CoachChuckFF/SoC-It_Hardware/sch.pdf

# USB

# POWER

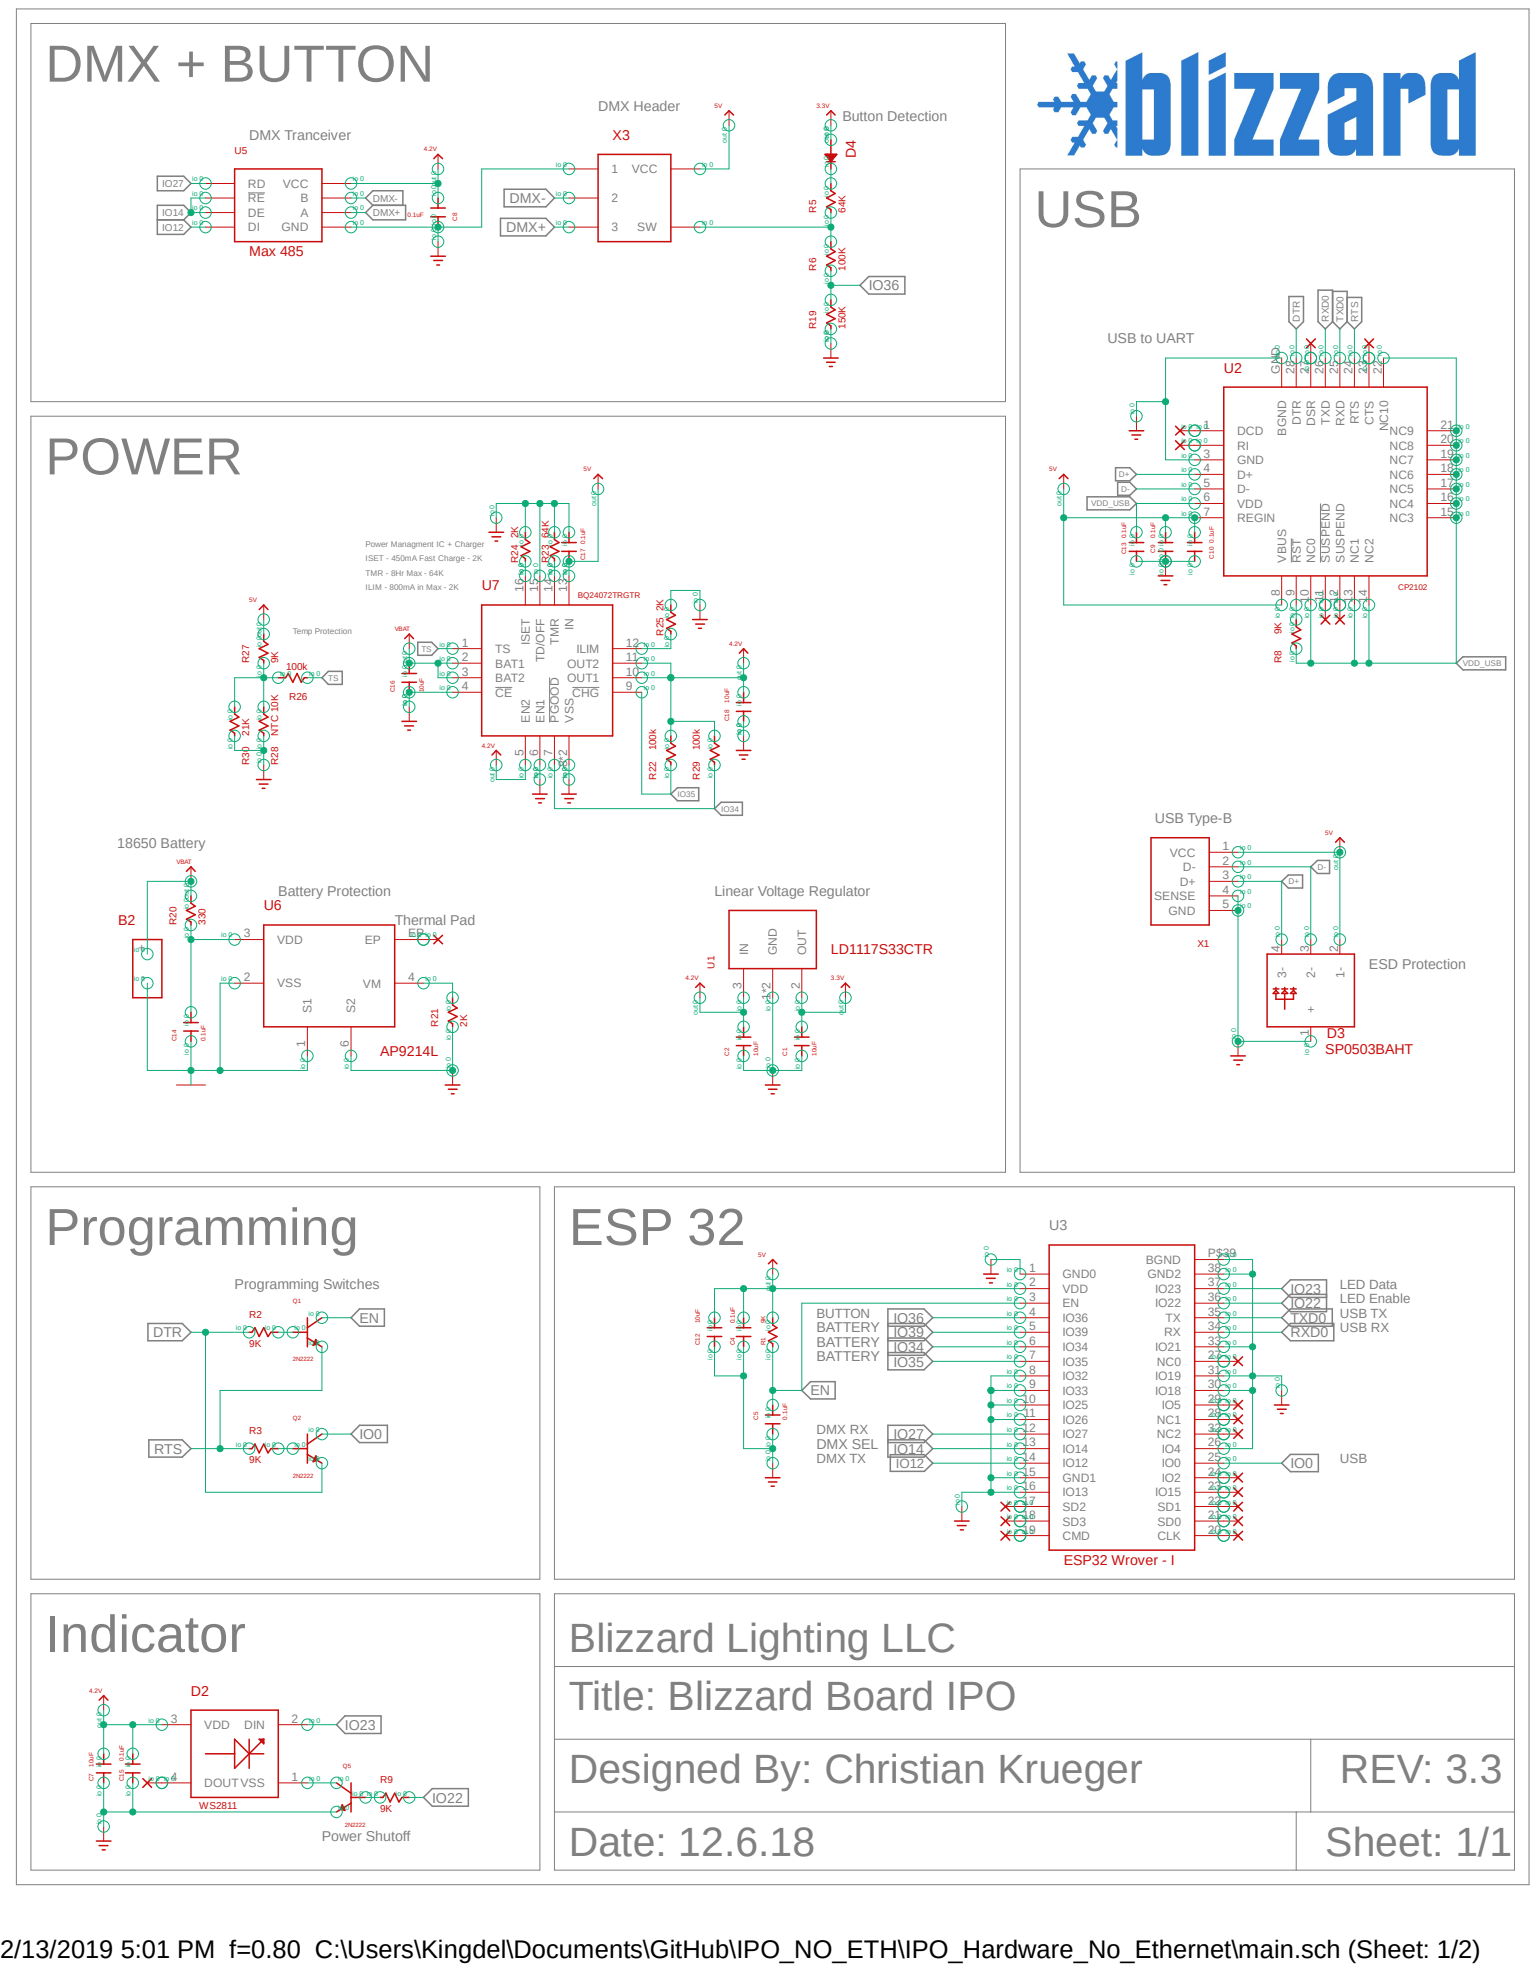
[picture p1: page 1]

9 NC0 10 SUSPEND 11 SUSPEND 12 NC1 13 NC2 14 NC3 15 NC4 16 NC5 17 NC6 18 NC7 19 NC8 20 NC9 NC10 21 22 CTS 23 RTS 24 RXD 25 TXD 26 DSR 27 DTR 28 BGND GND

Power Managment IC + Charger Temp Protection

7 VSS 8*2 CHG 9 OUT1 10 OUT2 11 ILIM 12 IN 13 TMR 14 TD/OFF 15 ISET 16

Thermal Pad Battery Protection

GND0 1 VDD 2 EN 3 | io 0

io 0 | IO26 11 | io 0
io 0 io 0 | IO27 12 IO14 13 IO12 14 GND1 15 | io 0

Blizzard Lighting LLC
Title: Blizzard Board IPO

Designed By: Christian Krueger | REV: 3.3
Date: 12.6.18 | Sheet: 1/1

2/13/2019 5:01 PM f=0.80 C:\Users\Kingdel\Documents\GitHub\IPO_NO_ETH\IPO_Hardware_No_Ethernet\main.sch (Sheet: 1/2)
