CoachChuckFF/SoC-It_Hardware/main.brd

## EAGLE design main.brd (2020-07-17)

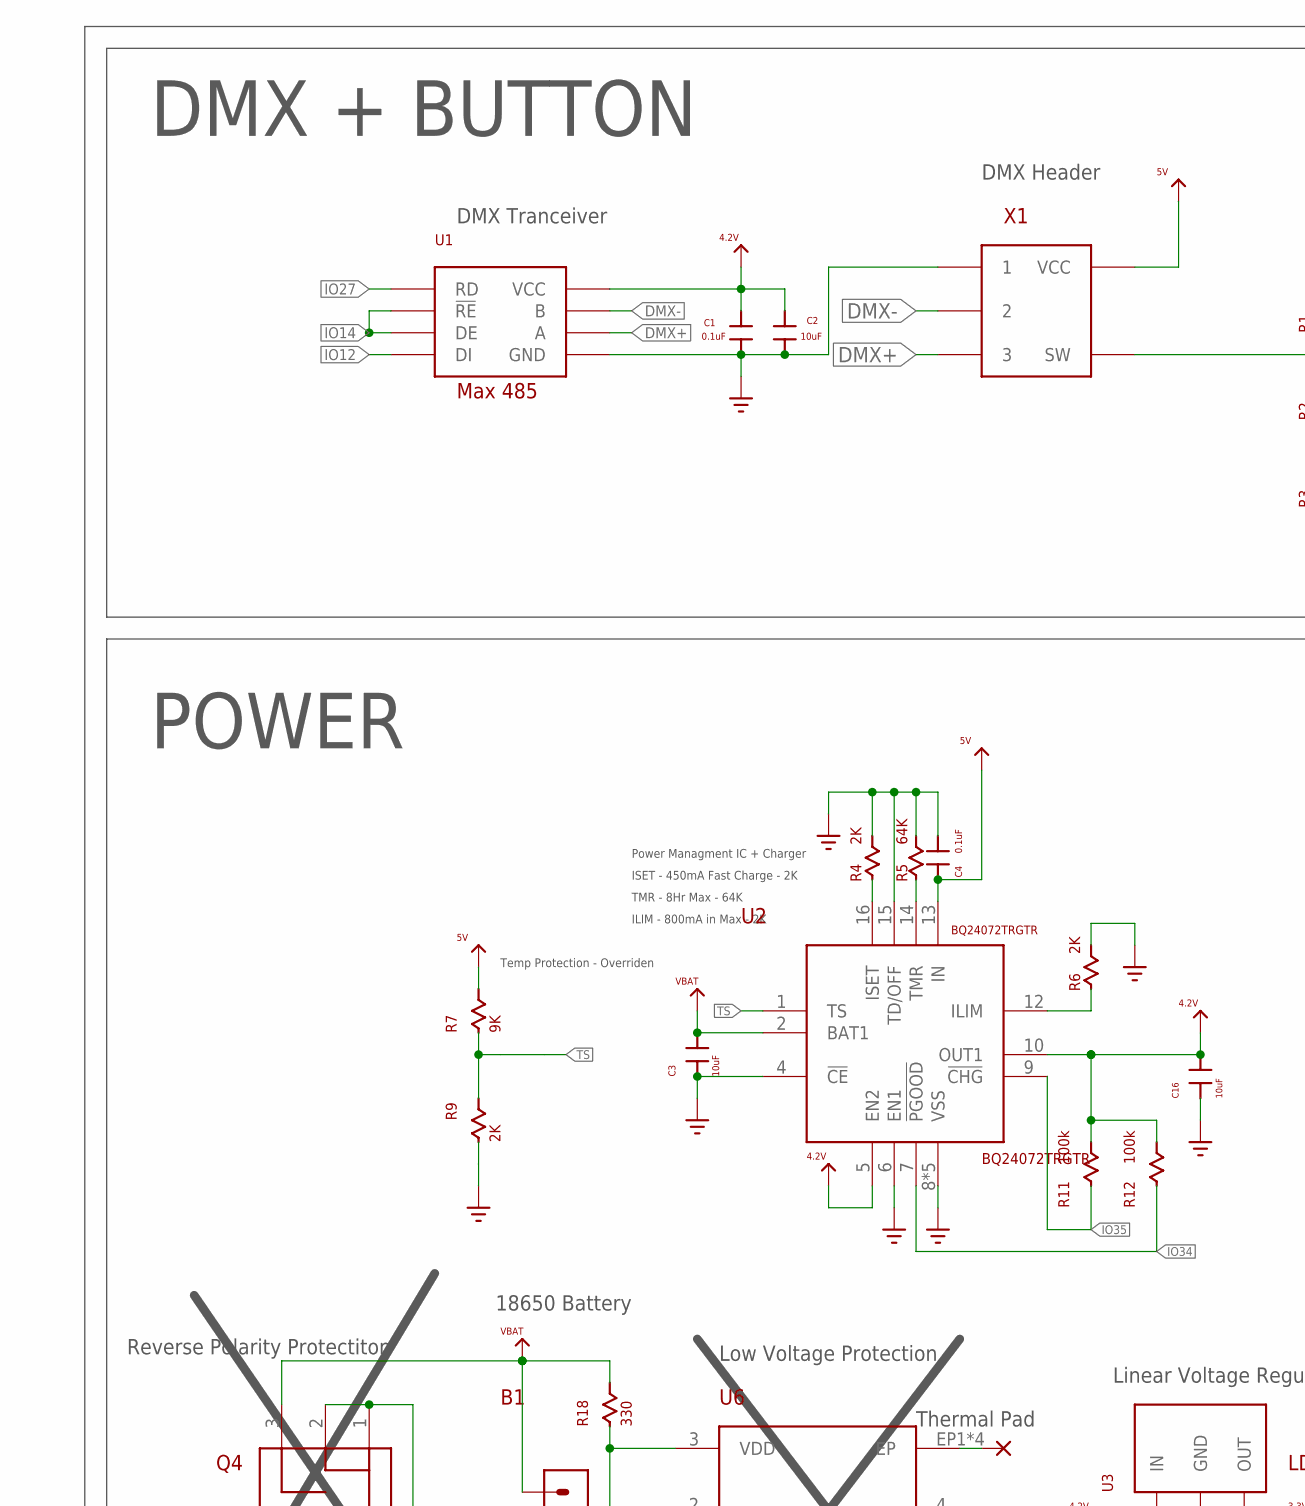
[picture p2: schematic main.sch, part in row 1, column 1]

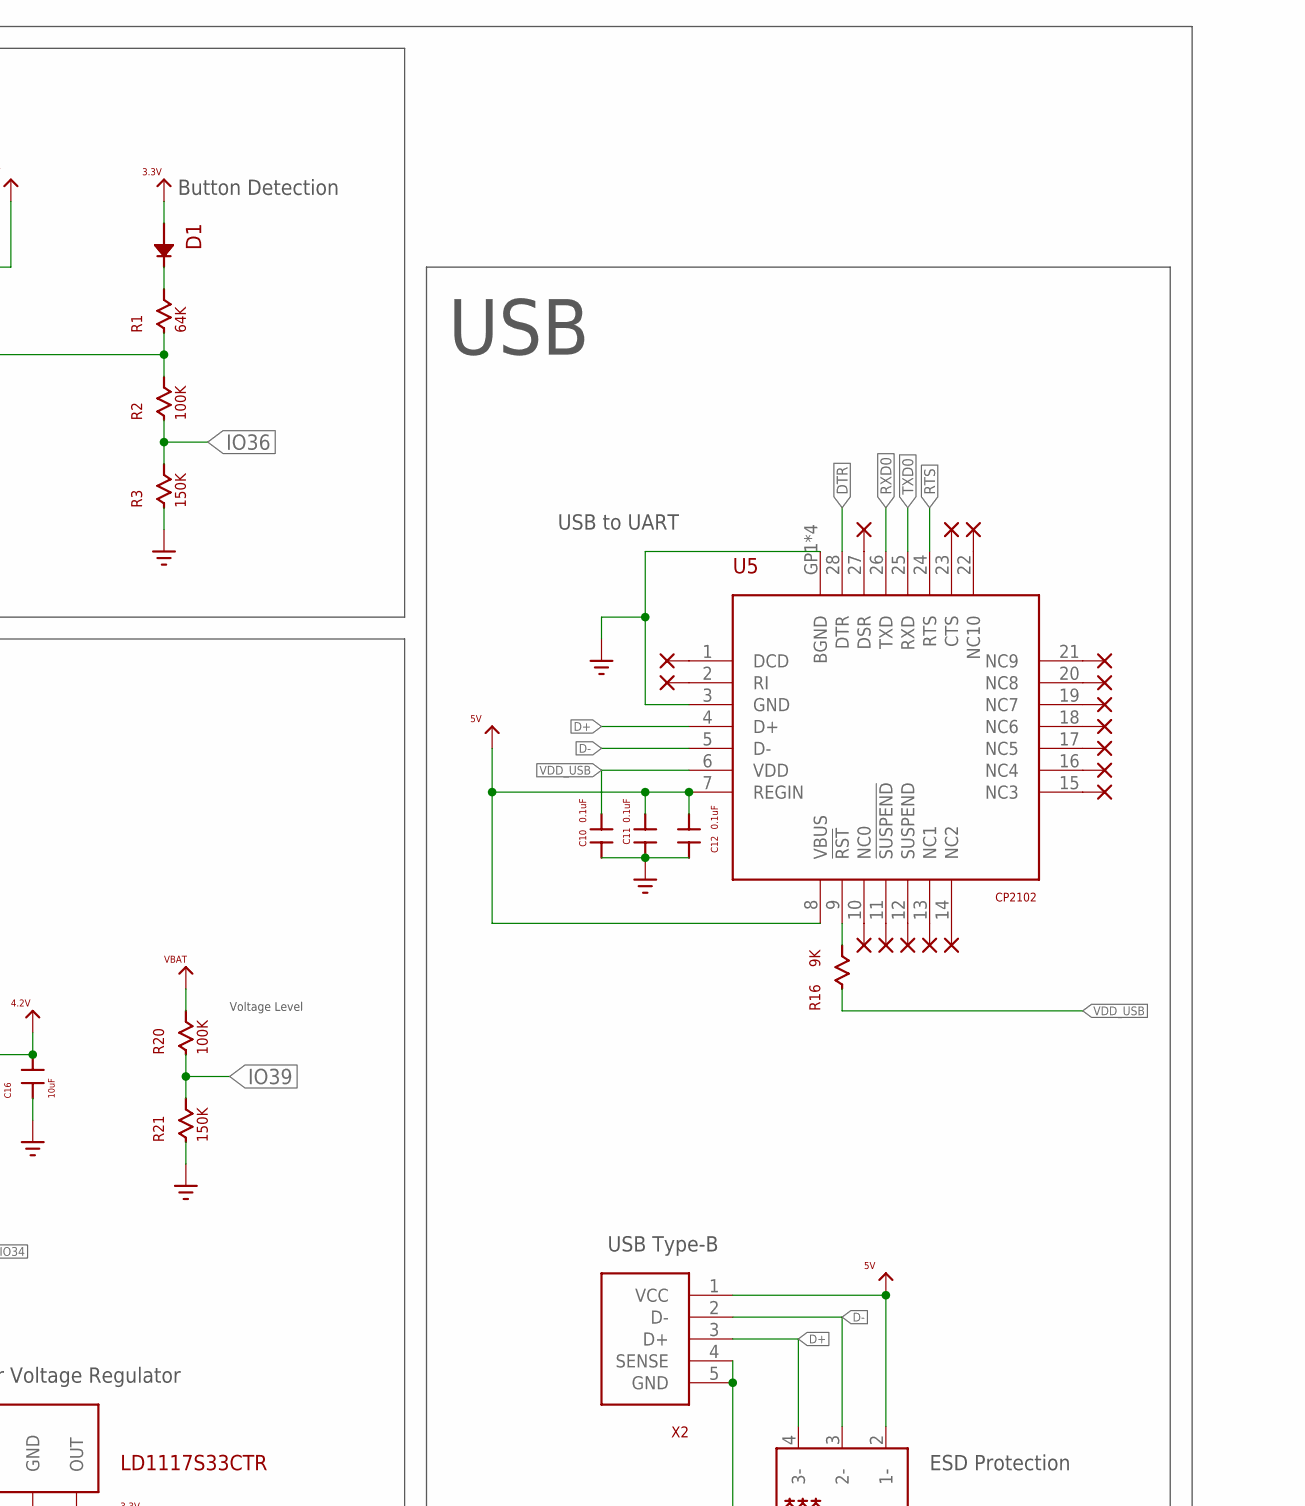
[picture p3: schematic main.sch, part in row 1, column 2]

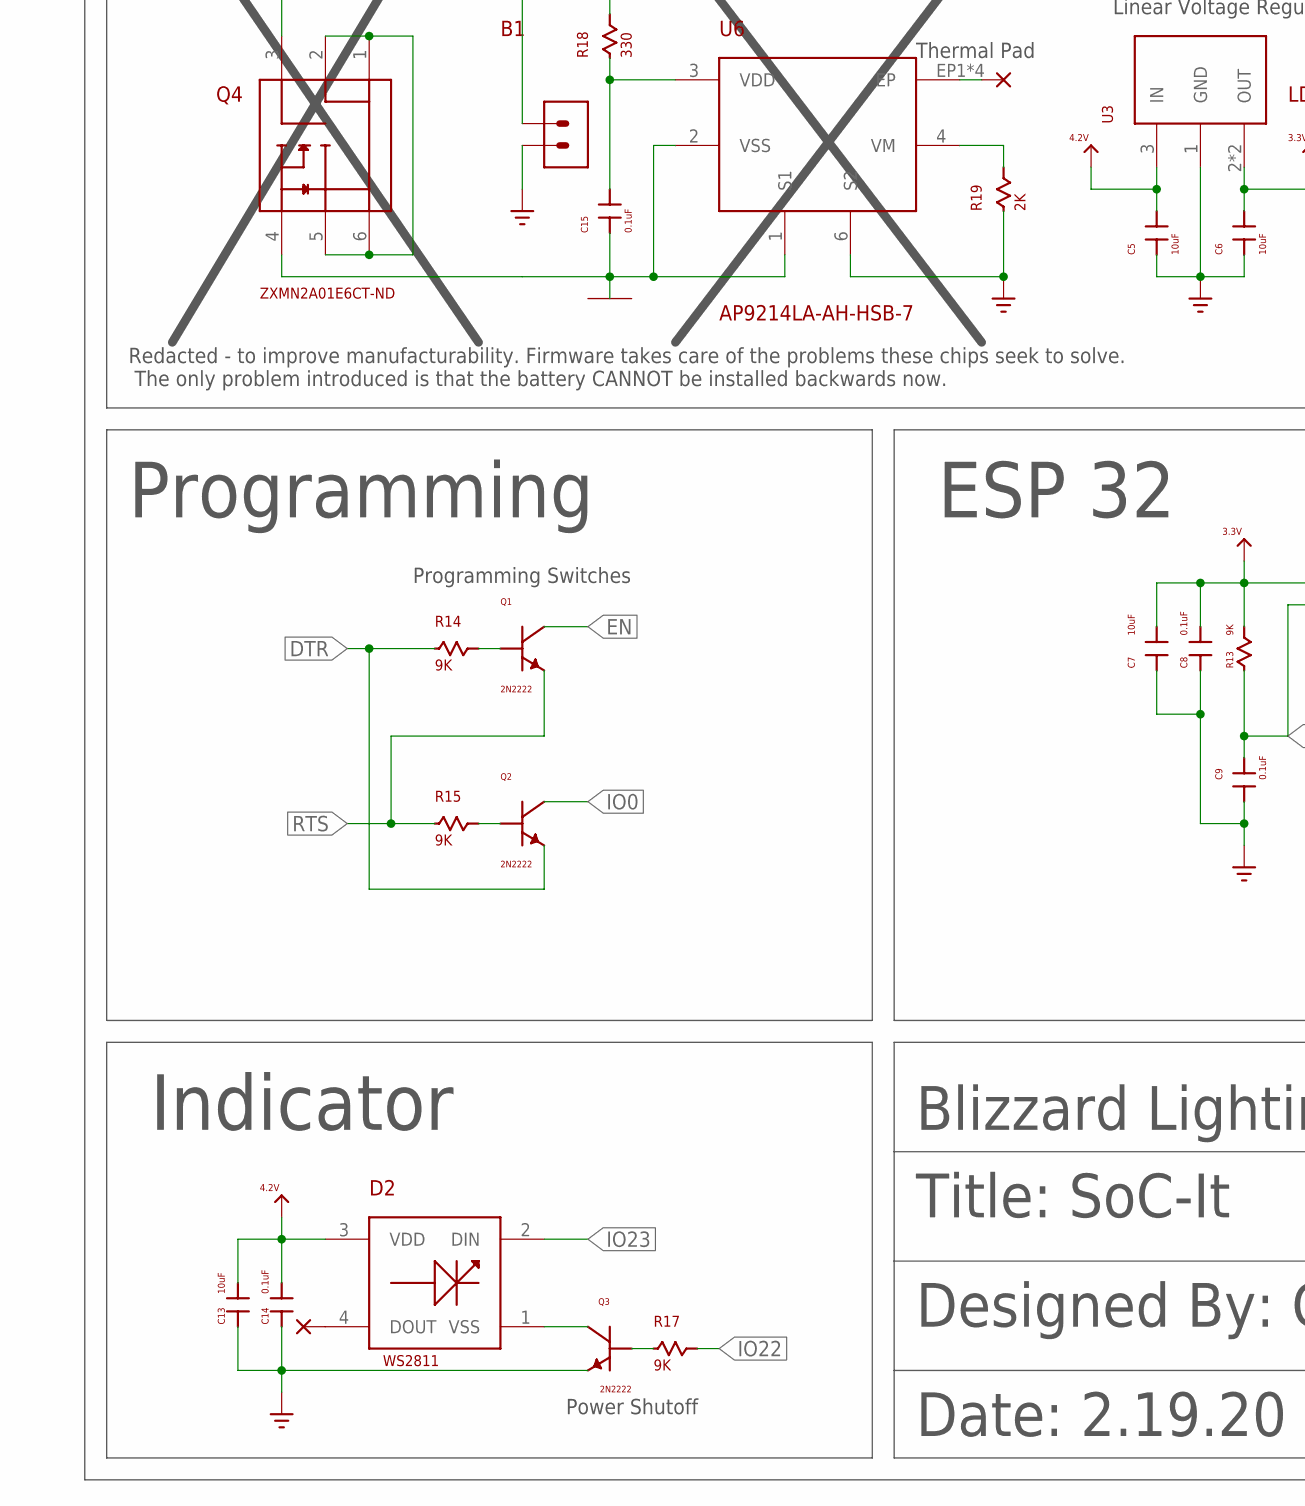
[picture p4: schematic main.sch, part in row 2, column 1]

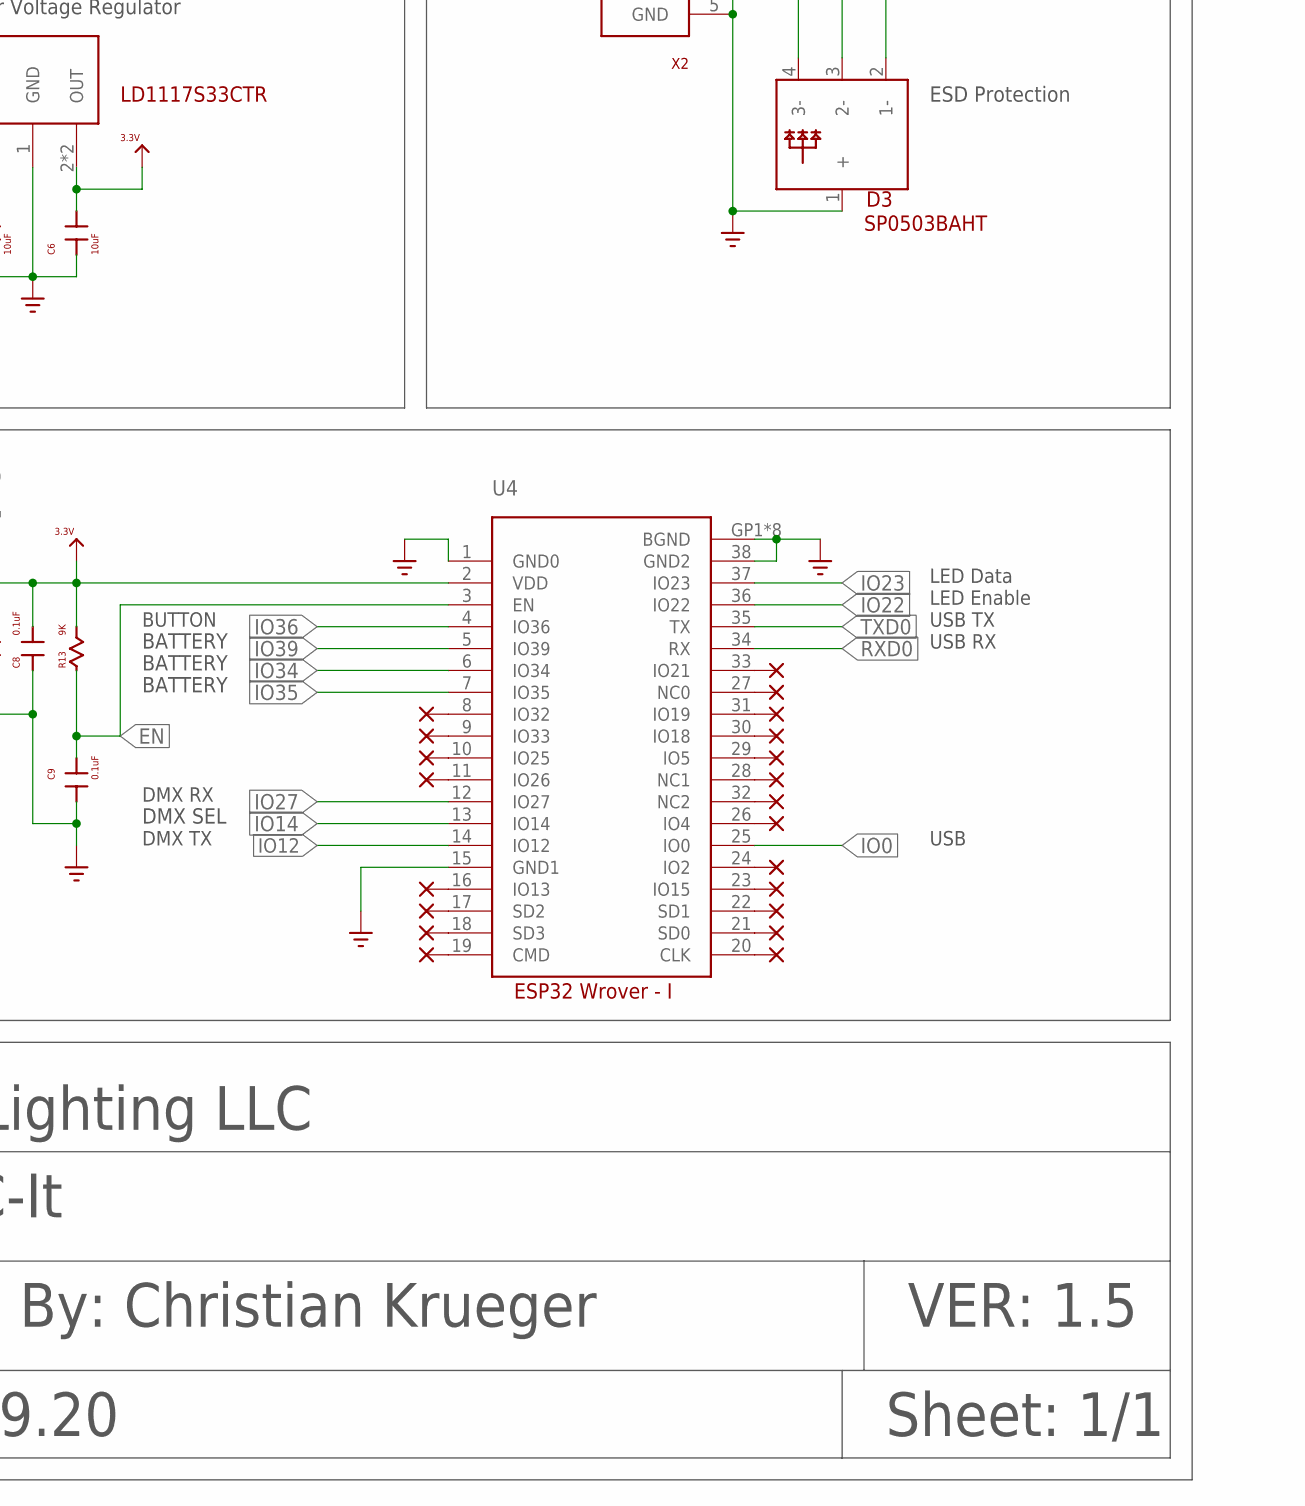
[picture p5: schematic main.sch, part in row 2, column 2]

Parts:
B1: 18650_BATTERY_DEV; 18650_BATTERY_PKG
C1, C4, C8, C9, C10, C11, C12, C14, C15: 0.1uF; CAPC1508X55
C2, C3, C5, C6, C7, C13, C16: 10uF; CAPC1508X55
D1: 0603_DIODE_DEV; 0603_DIODE
D2: 5050_DEV; 5050_PKG
D3: USB_ESD_DEVSOT143; SOT192P237X122-4
Q1, Q2, Q3: 2N2222; SOT95P242X120-3
Q4: N_MOSFET_DEVSOT23-6L_PKG; SOT95P280X125-6
R1, R5: 64K; RESC1608X55
R2, R20: 100K; RESC1608X55
R3, R21: 150K; RESC1608X55
R4, R6, R9, R19: 2K; RESC1608X55
R7, R13, R14, R15, R16, R17: 9K; RESC1608X55
R11, R12: 100k; RESC1608X55
R18: 330; RESC1608X55
U1: MAX_485_DEV3D; SOIC127P600X175-8
U2: BQ24072TRGTR_DEVBQ24072TRGTR; QFN50P300X300X100-17T168
U3: LD1117S33CTR_DEVLD1117S33CTR; SOT230P700X180-4
U4: ESP_32_WROVER_I_PKG; ESP32_WROVER_I_PKG
U5: USB_TO_UART_DEV; QFN50P500X500X100-28
U6: AP9214L_DEV; U-DFN2535-6_PKG
X1: XLR_FEMALE_PLUG_DEV; XLR_FEMALE_PLUG_PKG
X2: USB_ALI_DEV; CHEAP_USB

Connections:
3.3V: C6.2, C7.2, C8.2, D1.A+, R13.2, U3.2 (OUT), U3.4 (OUT), U4.2 (VDD)
4.2V: C1.1, C2.1, C5.2, C13.2, C14.2, C16.2, D2.3 (VDD), R11.2, R12.2, U1.8 (VCC), U2.5 (EN2), U2.10 (OUT1), U3.3 (IN)
5V: C4.1, C11.2, C12.2, D3.2 (1-), R7.2, U2.13 (IN), U5.7 (REGIN), U5.8 (VBUS), X1.VCC, X2.1 (VCC)
BATTERY_GROUND: Q4.1 (D1), Q4.2 (D2), Q4.5 (D3), Q4.6 (D4)
D+: D3.4 (3-), U5.4 (D+), X2.3 (D+)
D-: D3.3 (2-), U5.5 (D-), X2.2 (D-)
DMX+: U1.6 (A), X1.3
DMX-: U1.7 (B), X1.2
DTR: Q2.2 (E), R14.1, U5.28 (DTR)
EN: C9.2, Q1.3 (C), R13.1, U4.3 (EN)
GND: B1.-, C1.2, C2.2, C3.1, C4.2, C5.1, C6.1, C7.1, C8.1, C9.1, C10.1, C11.1, C12.1, C13.1, C14.1, C16.1, D3.1 (+), Q3.2 (E), R3.1, R4.2, R5.2, R6.2, R9.1, R19.1, R21.1, U1.5 (GND), U2.4 (!CE), U2.6 (EN1), U2.8 (VSS), U2.15 (TD/OFF), U2.GP1 (VSS), U2.GP2 (VSS), U2.GP3 (VSS), U2.GP4 (VSS), U3.1 (GND), U4.1 (GND0), U4.15 (GND1), U4.38 (GND2), U4.GP1 (BGND), U4.GP2 (BGND), U4.GP3 (BGND), U4.GP4 (BGND), U4.GP5 (BGND), U4.GP6 (BGND), U4.GP8 (BGND), U4.GP9 (BGND), U5.3 (GND), U5.GP1 (BGND), U5.GP2 (BGND), U5.GP3 (BGND), U5.GP4 (BGND), U6.6 (S2), X1.1, X2.4 (SENSE), X2.5 (GND)
IO0: Q2.3 (C), U4.25 (IO0)
IO12: U1.4 (DI), U4.14 (IO12)
IO14: U1.2 (!RE), U1.3 (DE), U4.13 (IO14)
IO22: R17.2, U4.36 (IO22)
IO23: D2.2 (DIN), U4.37 (IO23)
IO27: U1.1 (RD), U4.12 (IO27)
IO34: R12.1, U2.7 (!PGOOD), U4.6 (IO34)
IO35: R11.1, U2.9 (!CHG), U4.7 (IO35)
IO36: R2.1, R3.2, U4.4 (IO36)
IO39: R20.1, R21.2, U4.5 (IO39)
unnamed: D2.1 (VSS), Q3.3 (C)
unnamed: Q1.1 (B), R14.2
unnamed: Q2.1 (B), R15.2
unnamed: Q3.1 (B), R17.1
unnamed: R16.2, U5.9 (!RST)
unnamed: D1.C-, R1.2
unnamed: R1.1, R2.2, X1.SW
unnamed: R19.2, U6.4 (VM)
unnamed: C15.2, R18.1, U6.3 (VDD)
unnamed: R6.1, U2.12 (ILIM)
unnamed: R5.1, U2.14 (TMR)
unnamed: R4.1, U2.16 (ISET)
PROTECTION_GROUND: C15.1, Q4.4 (S), U6.1 (S1), U6.2 (VSS)
PROTECTION_THERMAL_PAD: U6.EP1 (EP), U6.EP2 (EP), U6.EP3 (EP), U6.EP4 (EP)
RTS: Q1.2 (E), R15.1, U5.24 (RTS)
RXD0: U4.34 (RX), U5.26 (TXD)
TS: R7.1, R9.2, U2.1 (TS)
TXD0: U4.35 (TX), U5.25 (RXD)
VBAT: B1.+, C3.2, Q4.3 (G), R18.2, R20.2, U2.2 (BAT1)
VDD_USB: C10.2, R16.1, U5.6 (VDD)

Notes on the sheet:
USB
POWER
DMX RX
DMX TX
USB TX
USB RX
LED Data
DMX + BUTTON
ESP 32
Title: SoC-It
Designed By: Christian Krueger
Blizzard Lighting LLC
Date: 2.19.20
Sheet: 1/1
VER: 1.5
BUTTON
Programming Switches
USB Type-B
Linear Voltage Regulator
Max 485
DMX Header
DMX SEL
Programming
Indicator
BATTERY
LED Enable
CP2102
Button Detection
WS2811
ESD Protection
DMX Tranceiver
USB to UART
Power Shutoff
Thermal Pad
Low Voltage Protection
18650 Battery
BQ24072TRGTR
ISET - 450mA Fast Charge - 2K
TMR - 8Hr Max - 64K
ILIM - 800mA in Max - 2K
Power Managment IC + Charger
Temp Protection - Overriden
LD1117S33CTR
ESP32 Wrover - I
Voltage Level
AP9214LA-AH-HSB-7
Reverse Polarity Protectiton
Redacted - to improve manufacturability. Firmware takes care of the problems these chips seek to solve. The only problem introduced is that the battery CANNOT be installed backwards now.

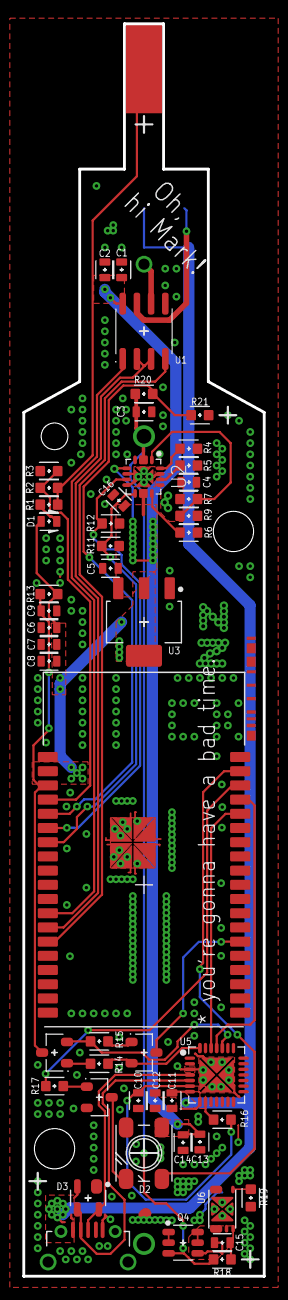
[picture p6: board main.brd from above]

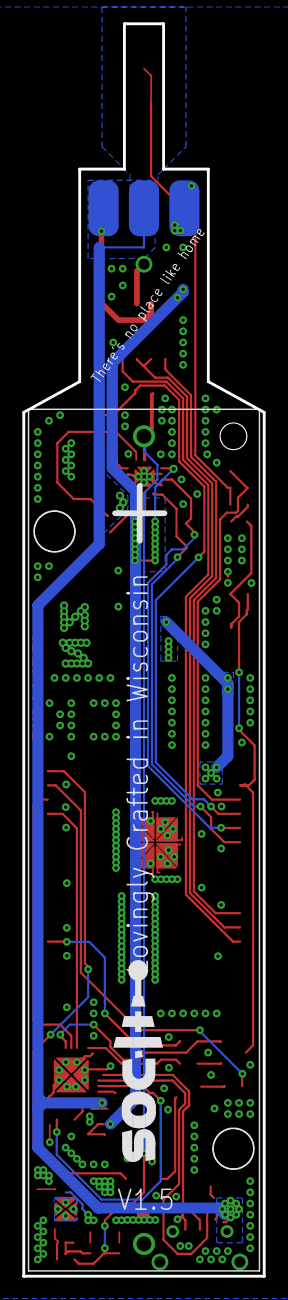
[picture p7: board main.brd from below]

Board: 2 copper layers, 21.5 x 112.0 mm, 51 parts (2 on the bottom side), 41 nets.
