CoachChuckFF/SoC-It_Hardware/Media/soc-it-manual-digital.pdf

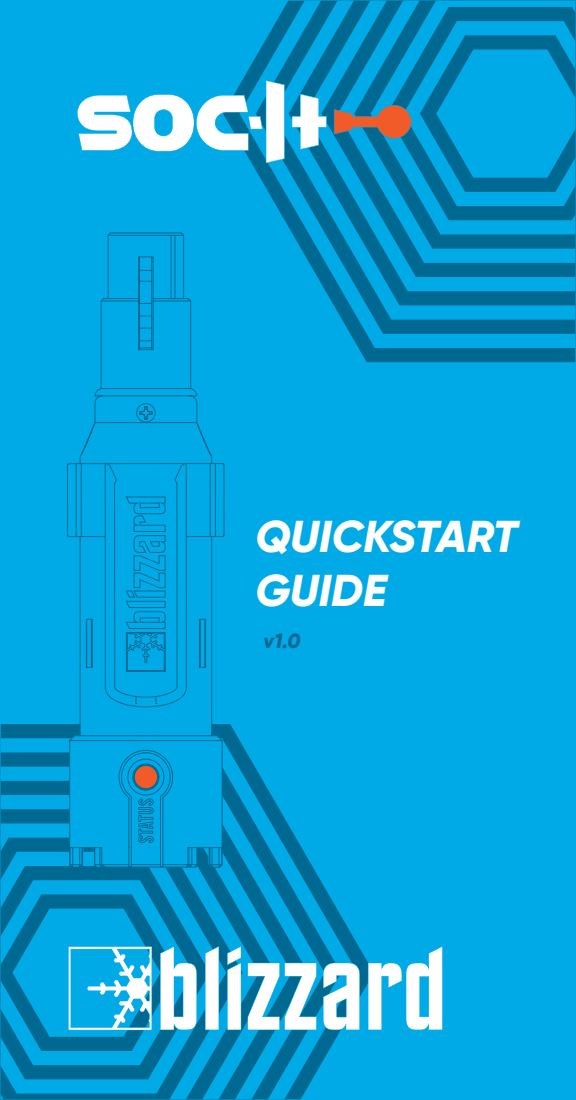
[picture p8: page 1]
QUICKSTART GUIDE

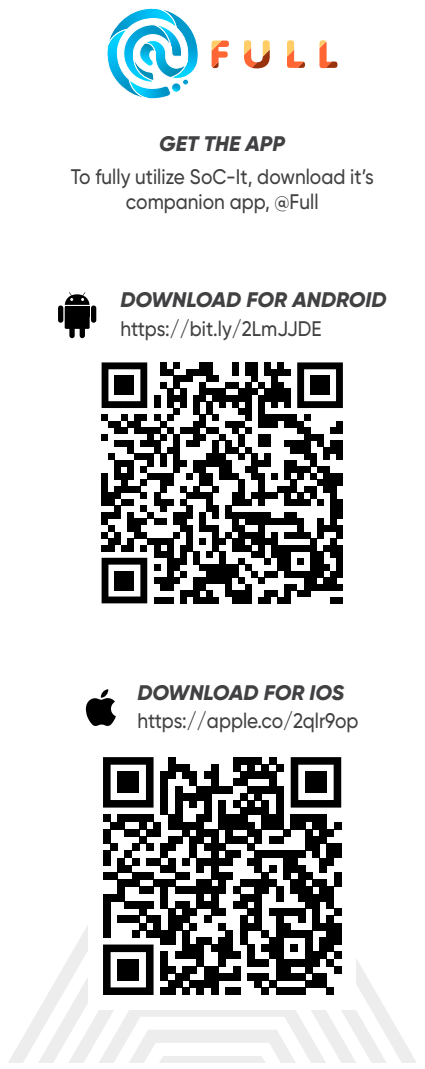
[picture p9: page 2]

GET THE APP

To fully utilize SoC-It, download it’s
companion app, @Full

DOWNLOAD FOR ANDROID
https://bit.ly/2LmJJDE

DOWNLOAD FOR IOS
https://apple.co/2qlr9op

## QUICK START

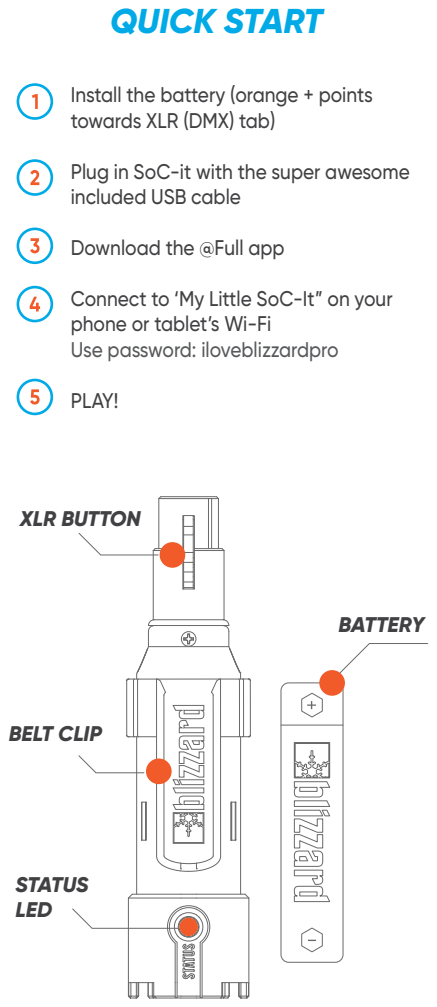
[picture p10: page 3]
PLAY!; BATTERY; XLR BUTTON; BELT CLIP; STATUS LED

Install the battery (orange + points
towards XLR (DMX) tab)

Plug in SoC-it with the super awesome
included USB cable

Download the @Full app

Connect to ‘My Little SoC-It” on your
phone or tablet’s Wi-Fi
Use password: iloveblizzardpro

## FUNCTIONS

ON - Hold XLR button until the LED lights up

OFF - 5 quick taps on the XLR Button

CHANGE CONNECTION TYPE (SSID or AP) -Tap button until green or blue, then hold, release and hold until white

REBOOT - Tap button until purple, then hold until white

FACTORY RESET - Tap button until red, then hold, release and hold until white

CHECK BATTERY - Double tap until orange 5 flashes = full
1 flash = empty
Breathing orange = charging
Solid orange = charged

IDLE COLOR MEANINGS
Flashing Blue - Waiting for a device to connect to SoC-It
Solid Blue - Device connected to SoC-It Flashing green - Trying to connect to SSID Solid green - Connected to SSID
Orange - Battery Level
White flicker - Data

Note: XLR Button is the tab on the XLR Head

## FAQs

Q: What is the password to connect to ‘My Little SoC-It’?
A: iloveblizzardpro
Q: I can’t connect to my Wi-Fi router, what gives?
A: SoC-It is 2.4GHz only, so a 5GHz signal will not work Q: How do I factory reset?
A: In @Full CONFIGURE › ‘Your SoC-It’ › Tools › factory reset or tap SoC-It button until red, hold until it flashes, release and hold again until it turns white. Q: I can connect to my SoC-It but no DMX is streaming
A: Try turning o your mobile data
A: @Full needs to be running in the foreground - if your screen goes dark, it’ll stop streaming (this will be fixed)
A: Try using a DMX cable in between your SoC-It and Fixture (If this fixes it, please contact Christian)
A: Panic (Also contact Christian)
Q: How do I know if the SoC-It is charging
A: keep double-tapping the SoC-It until it turns orange
Solid orange - done charging
Breathing orange - charging
Blinking orange - not charging (running on battery) Q: I can’t log in!?
A: The first time you log in you need to connected to the internet. So you can’t be connected to the SoC-It. After the first time, it’ll automatically log you in, no need to disconnect.
Q: Do you remember the 21st night of September? A: Yes

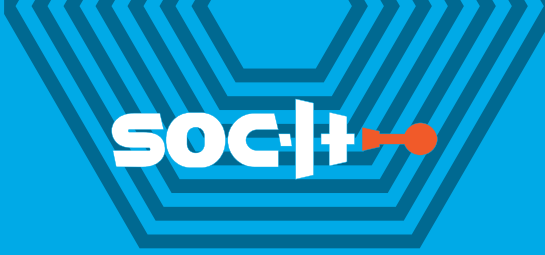
[picture p11: figure]

SoC-It is a product by Blizzard Pro that is 100% engineered and manufactured in Wisconsin, USA. The physical device is a Wi-Fi enabled Art-Net/sACN to DMX converter. It runs o of a 18650 battery and has a running battery life greater than 8 hours. SoC-It can be configured with its companion app @Full, available on Android and IOS. SoC-It was created by a 3 part team here at Blizzard. Will Komassa, the owner, created the physical housing and the box as well as mocked up a lot of @Full, Lucas Alonso sourced a lot of the components and worked with the plastic factory to mold the case, Christian Krueger designed the hardware, firmware and
programmed the app o of Mr. Will’s design. This is a very exciting product for us to be releasing soon and we hope you find it helpful!

From the development team - Thank you!
