CoachChuckFF/SoC-It_Hardware/(commit log)

2019-06-18 added pnp ulp
    [main.brd, main.sch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]
2019-06-18 added pnp ulp fixed
    [main.brd]
2019-10-15 pnp file added
    [SoC_It_Beta_Final.csv]
2020-02-19 fixed tab problems plus made some simplifications
    [main.brd, main.sch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]
2020-05-11 made the aperature size a bit bigger .3 -> .34
    [main.brd, main.sch]
2020-07-16 made MNGT holes bigger
2020-07-17 redacted battery saftey chips
    [main.brd, main.sch]
